samsanchezcar/PIC-Conveyor/(list of files, drawings)

Other design files:
esq.pdsprj
