samsanchezcar/PIC-Conveyor/pic-conveyor.X/LibLCDXC8.h

/* 
 * File:   LibLCDXC8.h
 * Author: Robin
 * Modificado por: Samuel S.
 *
 */

#ifndef LIBLCDXC8_H
#define	LIBLCDXC8_H

#ifdef	__cplusplus
extern "C" {
#endif




#ifdef	__cplusplus
}
#endif
#include<xc.h>
#ifndef _XTAL_FREQ
#define _XTAL_FREQ 20000000
#endif
#ifndef Datos
#define Datos LATD	//El puerto de conexi n de los datos el cual se puede cambiar
#endif
#ifndef RS
#define RS LATA3	//Los pines de control al LCD los cuales se
#endif
#ifndef E
#define E LATA4	//pueden cambiar
#endif

unsigned char interfaz=8;

void ConfiguraLCD(unsigned char);
void RetardoLCD(unsigned char);
void EnviaDato(unsigned char);
void InicializaLCD(void);
void HabilitaLCD(void);
void BorraLCD(void);
void CursorAInicio(void);
void ComandoLCD(unsigned char);
void EscribeLCD_c(unsigned char);
void EscribeLCD_n8(unsigned char, unsigned char);
void EscribeLCD_n16(unsigned int, unsigned char);
void EscribeLCD_d(double, unsigned char, unsigned char);
void MensajeLCD_Var(char *);
void DireccionaLCD(unsigned char);
void FijaCursorLCD(unsigned char,unsigned char);
void DesplazaPantallaD(void);
void DesplazaPantallaI(void);
void caracterpersonalizado(unsigned char direccion, unsigned char* patron);
void OcultarCursorLCD(void);
void MostrarCursorLCD(void);
void CrearCaracter(unsigned char pos, const unsigned char *data); 

void ConfiguraLCD(unsigned char a){
	if(a==4 | a ==8)
		interfaz=a;	
}
void EnviaDato(unsigned char a){
	if(interfaz==4){
		Datos=(Datos & 0b00001111) | (a & 0b11110000);
		HabilitaLCD();
		RetardoLCD(1);
		Datos=(Datos & 0b00001111) | (a<<4);
		//HabilitaLCD();
		RetardoLCD(1);
	}else if(interfaz==8){
		Datos=a;
	}	
}
void InicializaLCD(void){
//Funci n que inicializa el LCD caracteres
	RS=0;
	if(interfaz==4)
		Datos=(Datos & 0b00001111) | 0x30;
	else	
		Datos=0x3F;
	HabilitaLCD();
	RetardoLCD(1);
	if(interfaz==4)
		Datos=(Datos & 0b00001111) | 0x30;
	else	
		Datos=0x3F;
	HabilitaLCD();
	RetardoLCD(3);
	if(interfaz==4)
		Datos=(Datos & 0b00001111) | 0x30;
	else	
		Datos=0x3F;
	HabilitaLCD();
	RetardoLCD(4);
	if(interfaz==4){
		Datos=(Datos & 0b00001111) | 0x20;
		HabilitaLCD();
		RetardoLCD(4);
		EnviaDato(0x2F);
		HabilitaLCD();
		RetardoLCD(4);
	}
	BorraLCD();
	EnviaDato(0xF);
	HabilitaLCD();
	RetardoLCD(4);	
}
void HabilitaLCD(void){
//Funci n que genera los pulsos de habilitaci n al LCD 	
	E=1;
	__delay_us(40);
    //Delay1TCY();
	E=0;
}
void BorraLCD(void){
//Funci n que borra toda la pantalla	
	RS=0;
	EnviaDato(0x01);
	HabilitaLCD();
	RetardoLCD(2);
}
void CursorAInicio(){
//Funci n que lleva el cursor a la primera posici n o la de la
//primera l nea mas a la izquierda	
}	
void ComandoLCD(unsigned char a){
//Funci n que envia cualquier comando al LCD
	RS=0;
	if(a==1)
		BorraLCD();
	else if((a&0b11111110)==2)	
		CursorAInicio();
	else{	
		EnviaDato(a);
		HabilitaLCD();
		RetardoLCD(4);
	}		
}	
void EscribeLCD_c(unsigned char a){
//Funci n que escribe un caracter en la pantalla
//a es un valor en codigo ascii
//Ejemplo EscribeLCD_c('A');
	RS=1;
	EnviaDato(a);
	HabilitaLCD();
	RetardoLCD(4);
}
void EscribeLCD_n8(unsigned char a,unsigned char b){
//Funci n que escribe un n mero positivo de 8 bits en la pantalla
//a es el n mero a escribir, el cual debe estar en el rango de 0 a 255
//b es el n mero de digitos que se desea mostrar empezando desde las unidades
//Ejemplo EscribeLCD_n8(204,3);	
    unsigned char centena,decena,unidad;
	RS=1;
	switch(b){
		case 1: unidad=a%10;
				EnviaDato(unidad+48);
				HabilitaLCD();
				RetardoLCD(4);
				break;
		case 2:	decena=(a%100)/10;
				unidad=a%10;
				EnviaDato(decena+48);
				HabilitaLCD();
				RetardoLCD(4);
				EnviaDato(unidad+48);
				HabilitaLCD();
				RetardoLCD(4);
				break;
		case 3: centena=a/100;
				decena=(a%100)/10;
				unidad=a%10;
				EnviaDato(centena+48);
				HabilitaLCD();
				RetardoLCD(4);
				EnviaDato(decena+48);
				HabilitaLCD();
				RetardoLCD(4);
				EnviaDato(unidad+48);
				HabilitaLCD();
				RetardoLCD(4);
				break;
		default: break;
	}
}
void EscribeLCD_n16(unsigned int a,unsigned char b){
//Funci n que escribe un n mero positivo de 16 bits en la pantalla
//a es el n mero a escribir, el cual debe estar en el rango de 0 a 65535
//b es el n mero de digitos que se desea mostrar empezando desde las unidades
//Ejemplo EscribeLCD_n16(12754,5);	
    unsigned char decena,unidad;
	unsigned int centena,millar;
    RS=1;
	switch(b){
		case 1: unidad=a%10;
                EscribeLCD_c(unidad+48);
				break;
		case 2:	decena=(a%100)/10;
				unidad=a%10;
				EscribeLCD_c(decena+48);
                EscribeLCD_c(unidad+48);
				break;
		case 3: centena=(a%1000)/100;
                decena=(a%100)/10;
				unidad=a%10;
                EscribeLCD_c(centena+48);
				EscribeLCD_c(decena+48);
                EscribeLCD_c(unidad+48);
				break;
		case 4: millar=(a%10000)/1000;
                centena=(a%1000)/100;
                decena=(a%100)/10;
				unidad=a%10;
                EscribeLCD_c(millar+48);
				EscribeLCD_c(centena+48);
				EscribeLCD_c(decena+48);
                EscribeLCD_c(unidad+48);
				break;
		case 5: EscribeLCD_c(a/10000 +48);
				millar=(a%10000)/1000;
                centena=(a%1000)/100;
                decena=(a%100)/10;
				unidad=a%10;
                EscribeLCD_c(millar+48);
				EscribeLCD_c(centena+48);
				EscribeLCD_c(decena+48);
                EscribeLCD_c(unidad+48);
				break;
		default: break;
	}	
}
void EscribeLCD_d(double num, unsigned char digi, unsigned char digd){
	
}
void MensajeLCD_Var(char* a){
//Funci n que escribe una cadena de caracteres variable en la pantalla
//a es una cadena de caracteres guardada en una variable *char
//Ejemplo: char aux[4]="Hola"; MensajeLCD_Var(aux);	
    while (*a) {
        EscribeLCD_c(*a);
        a++;
    }
    

}
void DireccionaLCD(unsigned char a){
//Funci n que ubica el cursor en una posici n especificada
//a debe ser una direcci n de 8 bits valida de la DDRAM o la CGRAM	
	RS=0;
	EnviaDato(a);
	HabilitaLCD();
	RetardoLCD(4);
}
void FijaCursorLCD(unsigned char fila,unsigned char columna){
//Funci n que ubica el cursor en una fila y columna especificadas
//fila es un valor positivo que especifica la posici n del cursor de 1 a 4
//columna es un valor positivo que especifica la posici n del cursor de 1 a 80
//Si el display es de una fila, Ej: 8x1, tiene 80 columnas
//Si el display es de dos filas, Ej: 20x2, tiene 40 columnas
//Si el display es de cuatro filas, Ej: 20x4, tiene 20 columnas
	
}
void DesplazaPantallaD(void) {
    // Funci n que desplaza la pantalla a la derecha
    RS = 0;
    EnviaDato(0x1C); // Comando de desplazamiento a la derecha
    HabilitaLCD();
    RetardoLCD(4);
}

void DesplazaPantallaI(void) {
    // Funci n que desplaza la pantalla a la izquierda
    RS = 0;
    EnviaDato(0x18); // Comando de desplazamiento a la izquierda
    HabilitaLCD();
    RetardoLCD(4);
}
void DesplazaCursorD(void){
//Funci n que desplaza una sola vez la pantalla a la derecha
	
}
void DesplazaCursorI(void){
//Funci n que desplaza una sola vez la pantalla a la izquierda
	
}		
void RetardoLCD(unsigned char a){
	switch(a){
		case 1: __delay_ms(15);
                //Delay100TCYx(38); //Retardo de mas de 15 ms
				break;
		case 2: __delay_ms(1);
                __delay_us(640);
                //Delay10TCYx(41); //Retardo de mas de 1.64 ms
				break;
		case 3: __delay_us(100);
                //Delay10TCYx(3);	//Retardo de mas de 100 us
				break;
		case 4: __delay_us(40);
                //Delay10TCYx(1); //Retardo de mas de 40 us
				break;
		default:
				break;
	}
}

void caracterpersonalizado(unsigned char direccion, unsigned char* patron){
unsigned char i; 
ComandoLCD(0x40 | (direccion << 3)); // Direcci n en CGRAM, 0x40 es la base para CGRAM 
for(i = 0; i < 8; i++){ 
EscribeLCD_c(patron[i]); 
}
}
void OcultarCursorLCD(void){
    RS = 0;
    EnviaDato(0x0C); // Enviar comando para ocultar el cursor
    HabilitaLCD();
    RetardoLCD(4);
}
void MostrarCursorLCD(void) {
    RS = 0;
    EnviaDato(0x0E); // Enviar comando para mostrar el cursor (0x0E sin parpadeo)
                     // 0x0F seria con parpadeo
    HabilitaLCD();
    RetardoLCD(4);
}

void CrearCaracter(unsigned char pos, const unsigned char *data) {
    unsigned char i;
    
    RS = 0;
    EnviaDato(0x40 + (pos * 8));
    HabilitaLCD();
    RetardoLCD(4);
    
    
    RS = 1;
    for(i = 0; i < 8; i++) {
        EnviaDato(data[i]);
        HabilitaLCD();
        RetardoLCD(4);
    }
    
    
    RS = 0;
    EnviaDato(0x80);
    HabilitaLCD();
    RetardoLCD(4);
}
#endif	/* LIBLCDXC8_H */
